philippejadin/storybox/hardware/tp4056.png

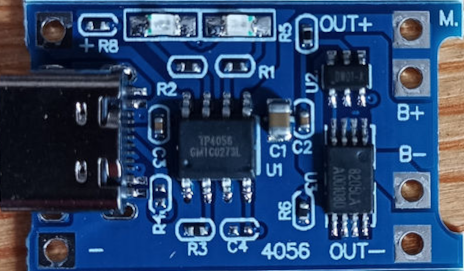
hardware/tp4056.png
