philippejadin/storybox/README.md

# Boite à histoire open source et open hardware, un projet du Fablab'ke

Consultez le repository officile du projet ici : https://github.com/fablabke/boite-histoire
