philippejadin/storybox/hardware/bom_mouser.xls

SHOPPING BASKET
This is not an invoice
05-Apr-24 07:38:11
 | Mouser No | Mfr. No | Manufacturer | Customer No | Description | RoHS | Lifecycle | Order Qty. | Price (EUR) | Ext.: (EUR)
1 | 179-CDS-5026-54E | CDS-5026-54E | CUI Devices |  | Speakers & Transducers 50 mm round, 26 mm deep, Foam + Paper, NdFeB, 5W, 4 ohm, 180Hz, solder eyelets | RoHS Compliant | New Product | 5 | 2,99 € | 14,95 €
2 | 485-4682 | 4682 | Adafruit |  | Memory IC Development Tools Adafruit Micro SD SPI or SDIO Card Breakout Board - 3V ONLY! | RoHS Compliant |  | 50 | 3,26 € | 163,00 €
3 | 485-3006 | 3006 | Adafruit |  | Amplifier IC Development Tools I2S 3W Class D Amp Breakout MAX98357A | RoHS Compliant |  | 15 | 5,53 € | 82,95 €
4 | 637-1N5817 | 1N5817 | Diotec Semiconductor |  | Schottky Diodes & Rectifiers Schottky, DO-15, 20V, 1A | RoHS Compliant By Exemption |  | 50 | 0,181 € | 9,05 €
5 | 179-PTN16-A10220K1B1 | PTN16-A10220K1B1 | CUI Devices |  | Potentiometers 17mm Pot, 10Kohm, Knurled shaft | RoHS Compliant | New Product | 30 | 1,15 € | 34,50 €
6 | 710-61302011821 | 61302011821 | Wurth Elektronik |  | Headers & Wire Housings WR-PHD 2.54mm Socket Header 20 pins | RoHS Compliant |  | 60 | 0,76 € | 45,60 €
7 | 710-61301611821 | 61301611821 | Wurth Elektronik |  | Headers & Wire Housings WR-PHD 2.54 mm Socke t Header; 16 pins | RoHS Compliant By Exemption |  | 30 | 0,567 € | 17,01 €
8 | 737-PH1-20-UA | PH1-20-UA | Adam Tech |  | Headers & Wire Housings 20P AU FLASH SINGLE ROW STRAIGHT | RoHS Compliant | New At Mouser | 60 | 0,193 € | 11,58 €
9 | 490-SJ1-3525NG-GR | SJ1-3525NG-GR | CUI Devices |  | Phone Connectors 3.5 mm, Stereo, Right Angle, Through Hole, Isolated Ground, 3 Conductors, 0 2 Internal Switches, Audio Jack Connector |  |  | 60 | 0,622 € | 37,32 €
10 | 358-SC0918 | SC0918 | Raspberry Pi |  | Single Board Computers Raspberry Pi Pico W | RoHS Compliant | New At Mouser | 20 | 5,58 € | 111,60 €
11 | 665-AS07108POR | AS07108PO-R | PUI Audio |  | Speakers & Transducers 8 OHM OVAL | RoHS Compliant |  | 10 | 3,11 € | 31,10 €
12 | 738-13154 | 13154 | AIM - American Iron and Metal |  | Solder Sn60/Pb40 OAJ 2% .032 DIA 1 lb. | No |  | 1 | 26,31 € | 26,31 €
13 | 179-CMS-2811-44E | CMS-2811-44E | CUI Devices |  | Speakers & Transducers 28 mm round, 11 mm deep, Foam, NdFeB, 3W, 4 ohm, 300Hz, solder eyelets | RoHS Compliant | New Product | 10 | 3,18 € | 31,80 €
14 | 602-3050-100-03 | 3050 RD005 | Alpha Wire |  | Hook-up Wire 24AWG 7/32 PVC 100ft SPOOL RED | RoHS Compliant |  | 1 | 29,63 € | 29,63 €
15 | 602-3050-100-02 | 3050 BK005 | Alpha Wire |  | Hook-up Wire 24AWG 7/32 PVC 100ft SPOOL BLACK | RoHS Compliant |  | 1 | 29,63 € | 29,63 €
16 | 602-3050/1-100-05 | 3050/1 YL005 | Alpha Wire |  | Hook-up Wire 24AWG SOLID PVC 100ft SPOOL YELLOW | RoHS Compliant |  | 1 | 24,47 € | 24,47 €
17 | 602-3050-100-06 | 3050 BL005 | Alpha Wire |  | Hook-up Wire 24AWG 7/32 PVC 100ft SPOOL BLUE | RoHS Compliant |  | 1 | 29,63 € | 29,63 €
18 | 179-TS14121280100SCR | TS14-1212-80-BK-100-SCR-D | CUI Devices |  | Tactile Switches 12 x 12 mm 8 mm 100 gf Short Crimped Black Through Hole SPST | RoHS Compliant | New Product | 120 | 0,173 € | 20,76 €
19 | 612-RA11131121 | RA11131121 | E-Switch |  | Rocker Switches 10A 125VAC 4.8mm Tab Off-On | RoHS Compliant |  | 30 | 0,525 € | 15,75 €
20 | 708-CF12JT100K | CF12JT100K | SEI Stackpole |  | Carbon Film Resistors - Through Hole 100KOhms 1/2W 5% Std Carbon | RoHS Compliant | New At Mouser | 100 | 0,02 € | 2,00 €
21 | 524-SDCS2/64GB | SDCS2/64GB | Kingston |  | Memory Cards 64GB Canvas Select Plus microSD |  | New Product | 20 | 6,38 € | 127,60 €
22 | 497-SP500202-1 | SP500202-1 | DB Unlimited |  | Speakers & Transducers Dynamic Speaker | RoHS Compliant |  | 10 | 2,21 € | 22,10 €
By submitting your order you agree to these terms and conditions. (https://www.mouser.be/saleterms) |  |  |  |  |  |  |  |  | Merchandise: | 918,34 €
Prices are reflected at the date and time shown. |  |  |  |  |  |  |  |  | Delivery Charge: | 0,00 €
