philippejadin/storybox/hardware/pico_label_plate/PicoLabelPlate.stl

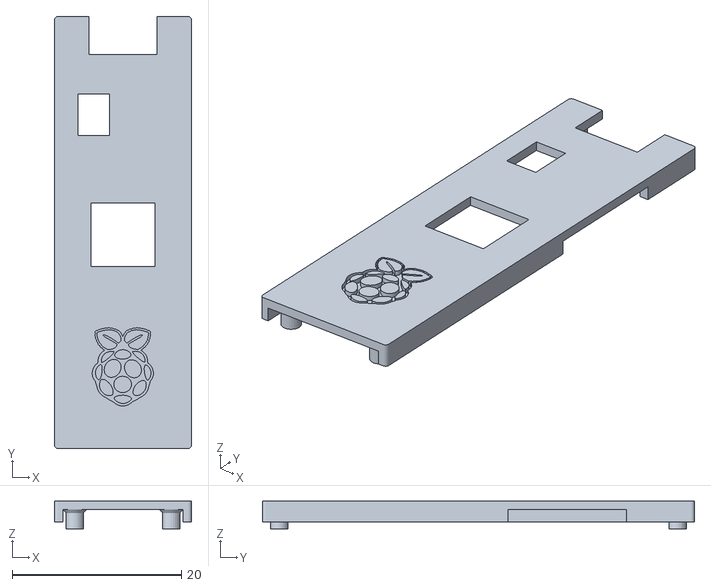
[picture p2: CAD file, 2024-04-19]
hardware/pico_label_plate/PicoLabelPlate.stl
16.2 x 51.0 x 3.30
