philippejadin/storybox/hardware/storybox/pdf/storybox.pdf

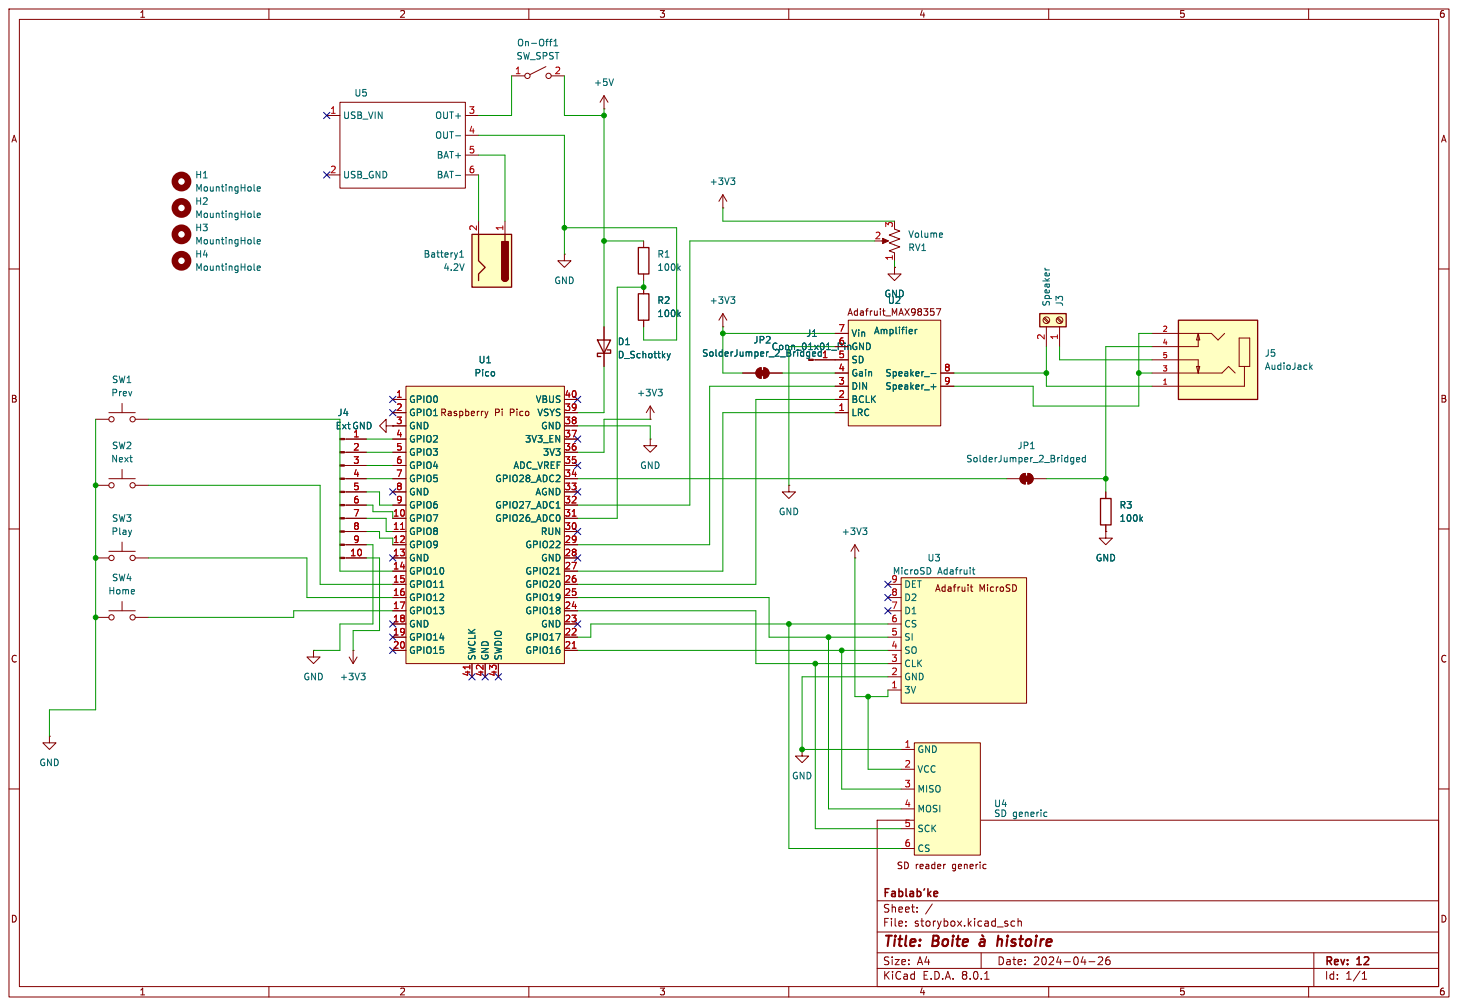
[picture p3: page 1]

File: storybox.kicad_sch Sheet: / Fablab'ke GND

Id: 1/1 Title: Boite þÿàhistoire
