philippejadin/storybox/hardware/pico_label_plate/PicoLabelPlateLabels 32ex.pdf

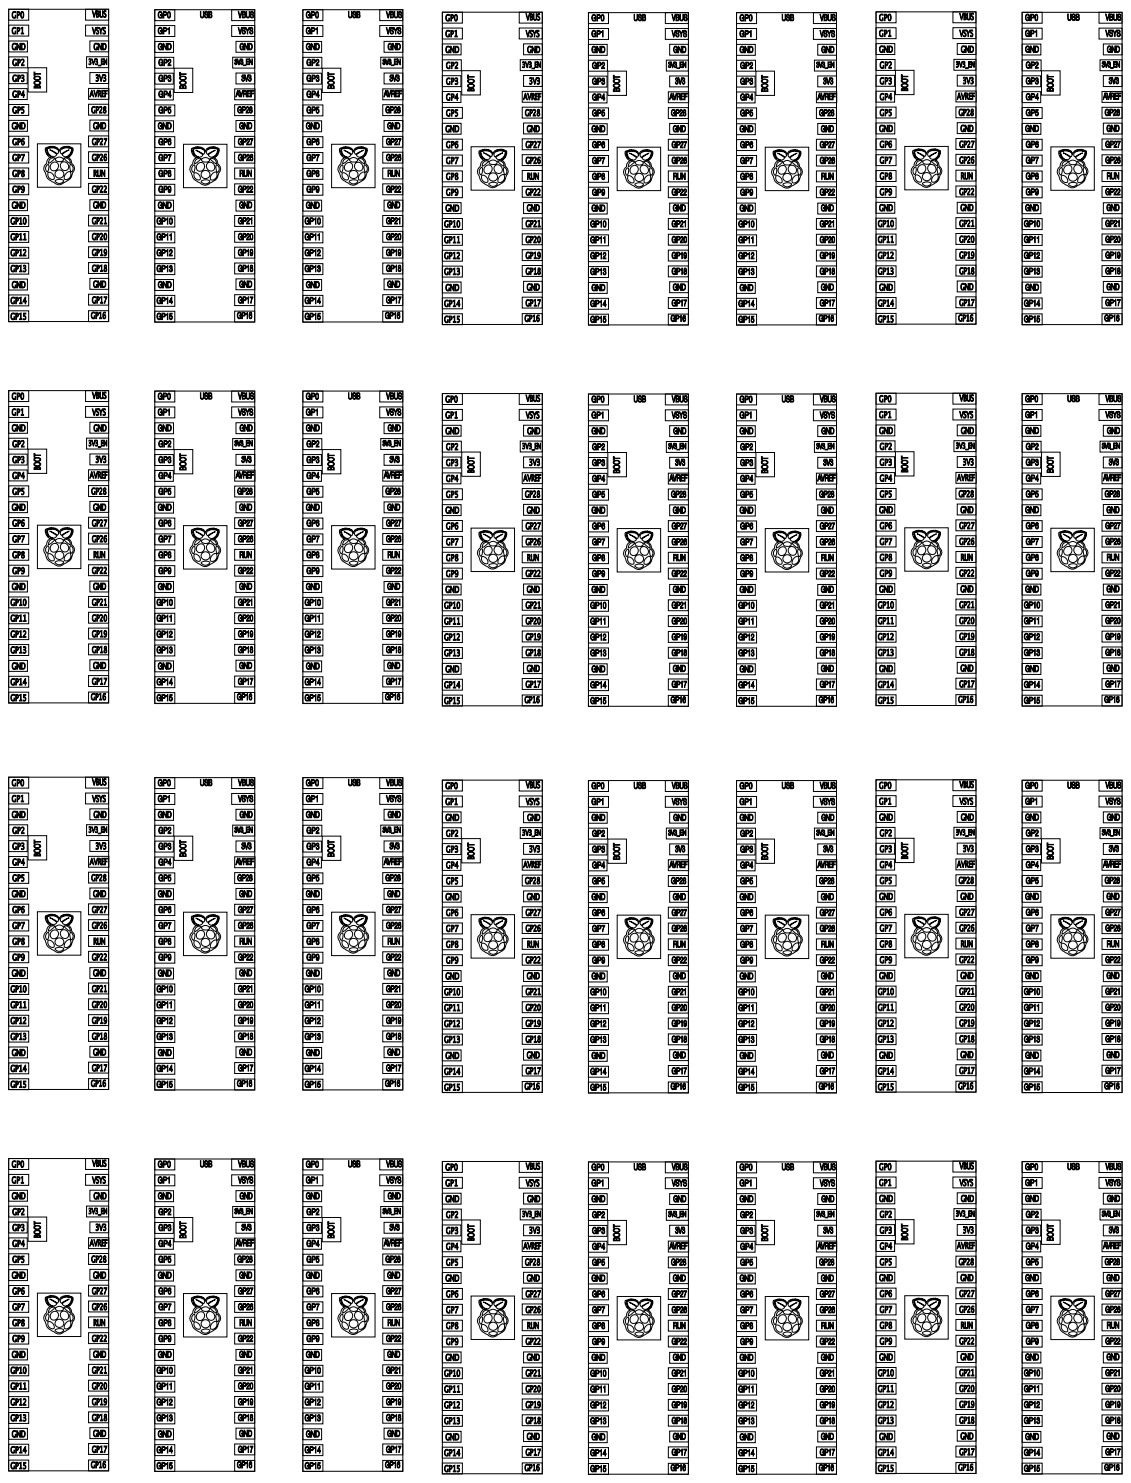
[picture p4: page 1]
