philippejadin/storybox/hardware/storybox/schematic.pdf

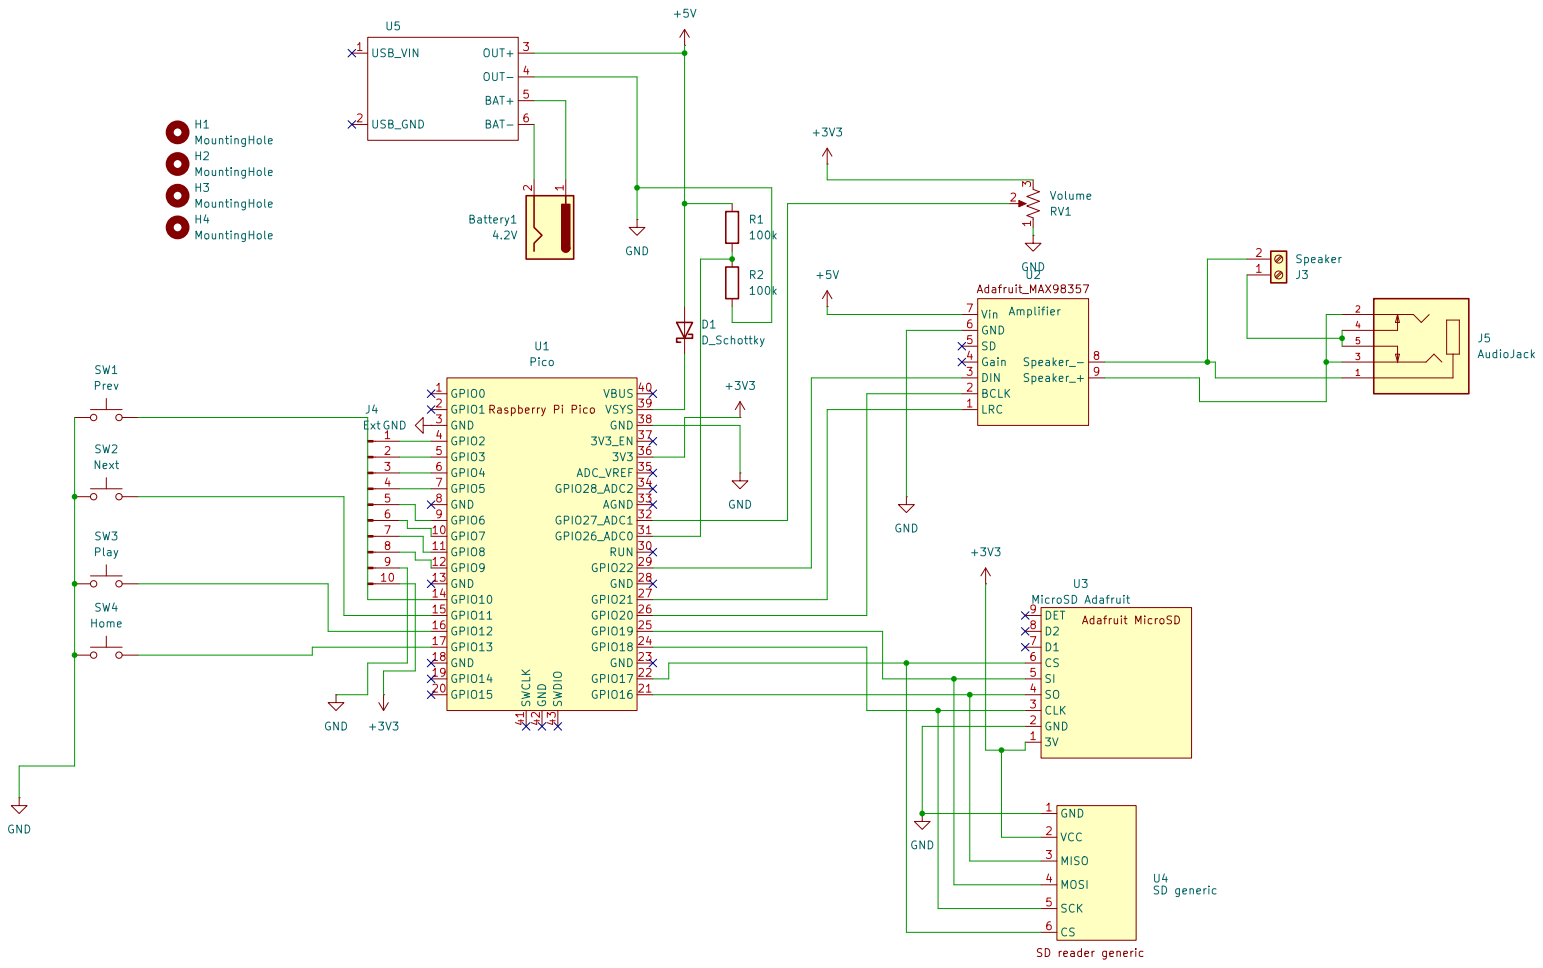
[picture p5: page 1]
