philippejadin/storybox/hardware/storybox/storybox.pdf

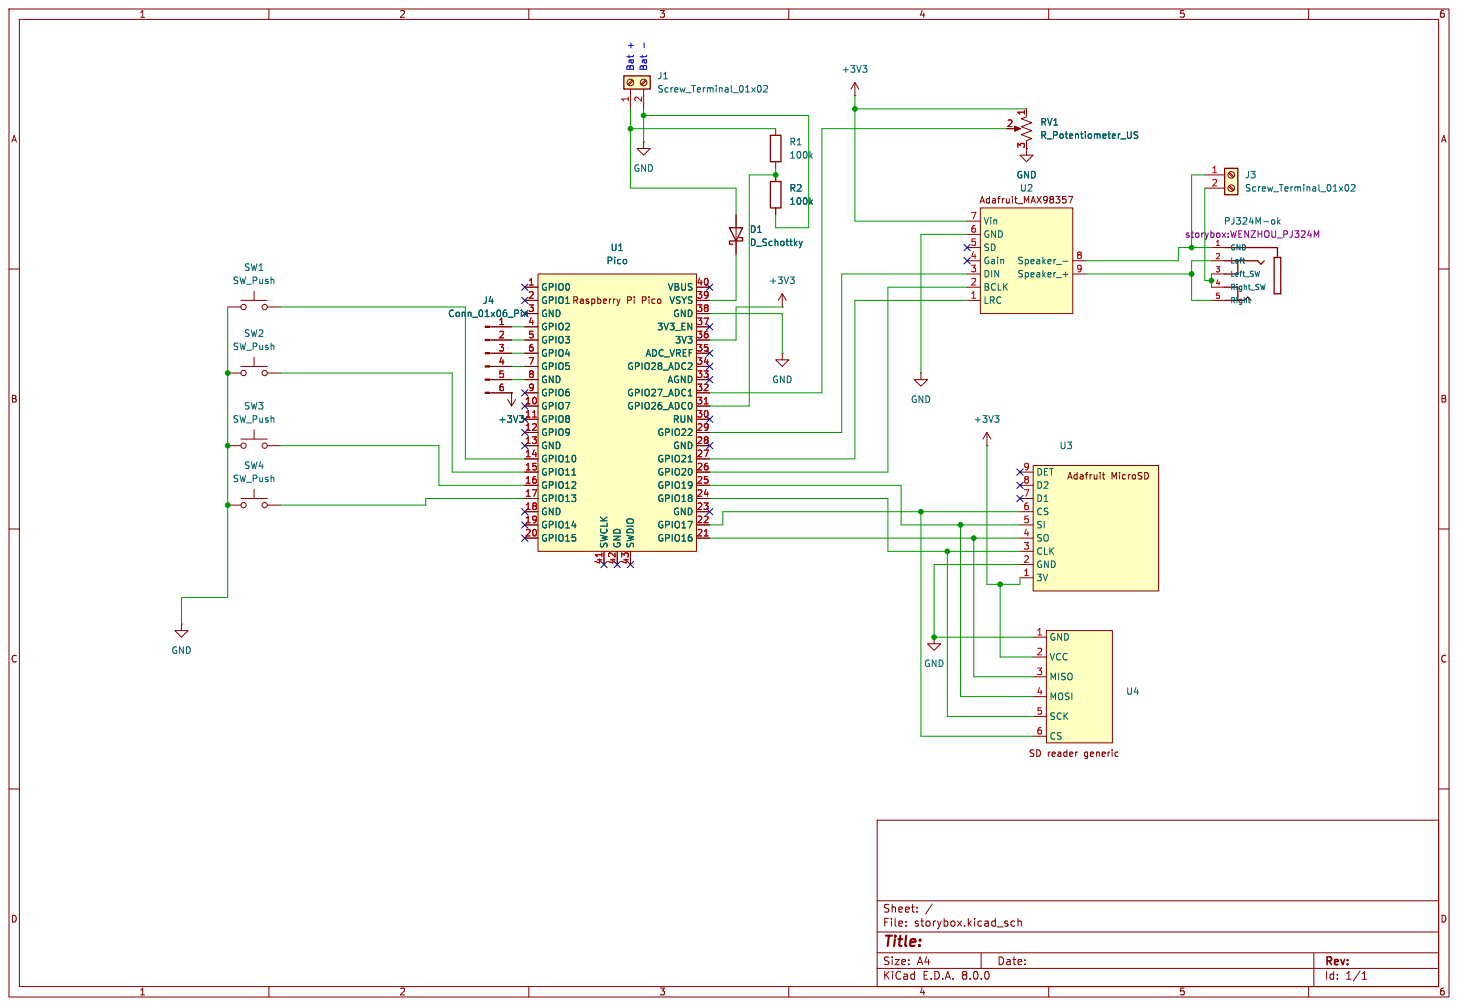
[picture p6: page 1]
