philippejadin/storybox/hardware/storybox/svg/output.pdf

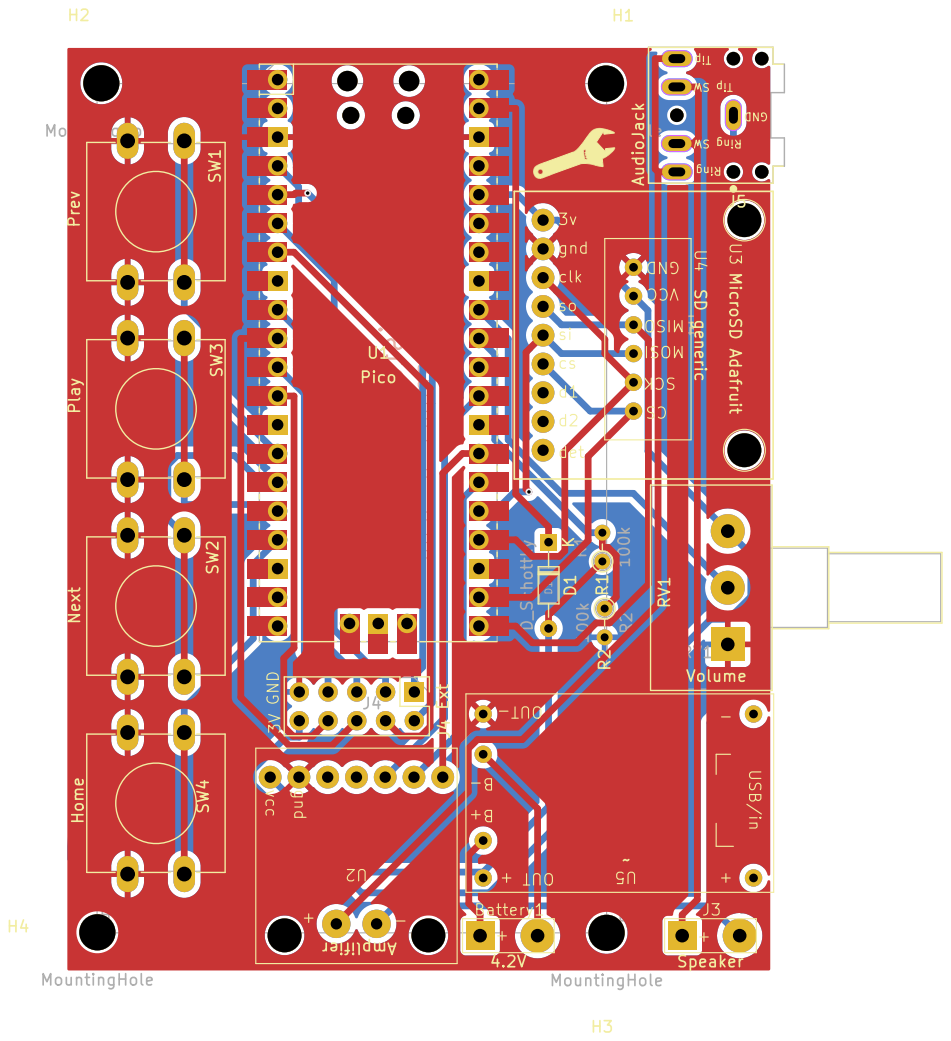
[picture p7: page 1]
