philippejadin/storybox/(list of files, drawings)

Other design files:
hardware/storybox/storybox.dsn
