philippejadin/storybox/hardware/storybox/storybox.kicad_pcb

## KiCad design hardware/storybox/storybox.kicad_pcb (2024-05-24)

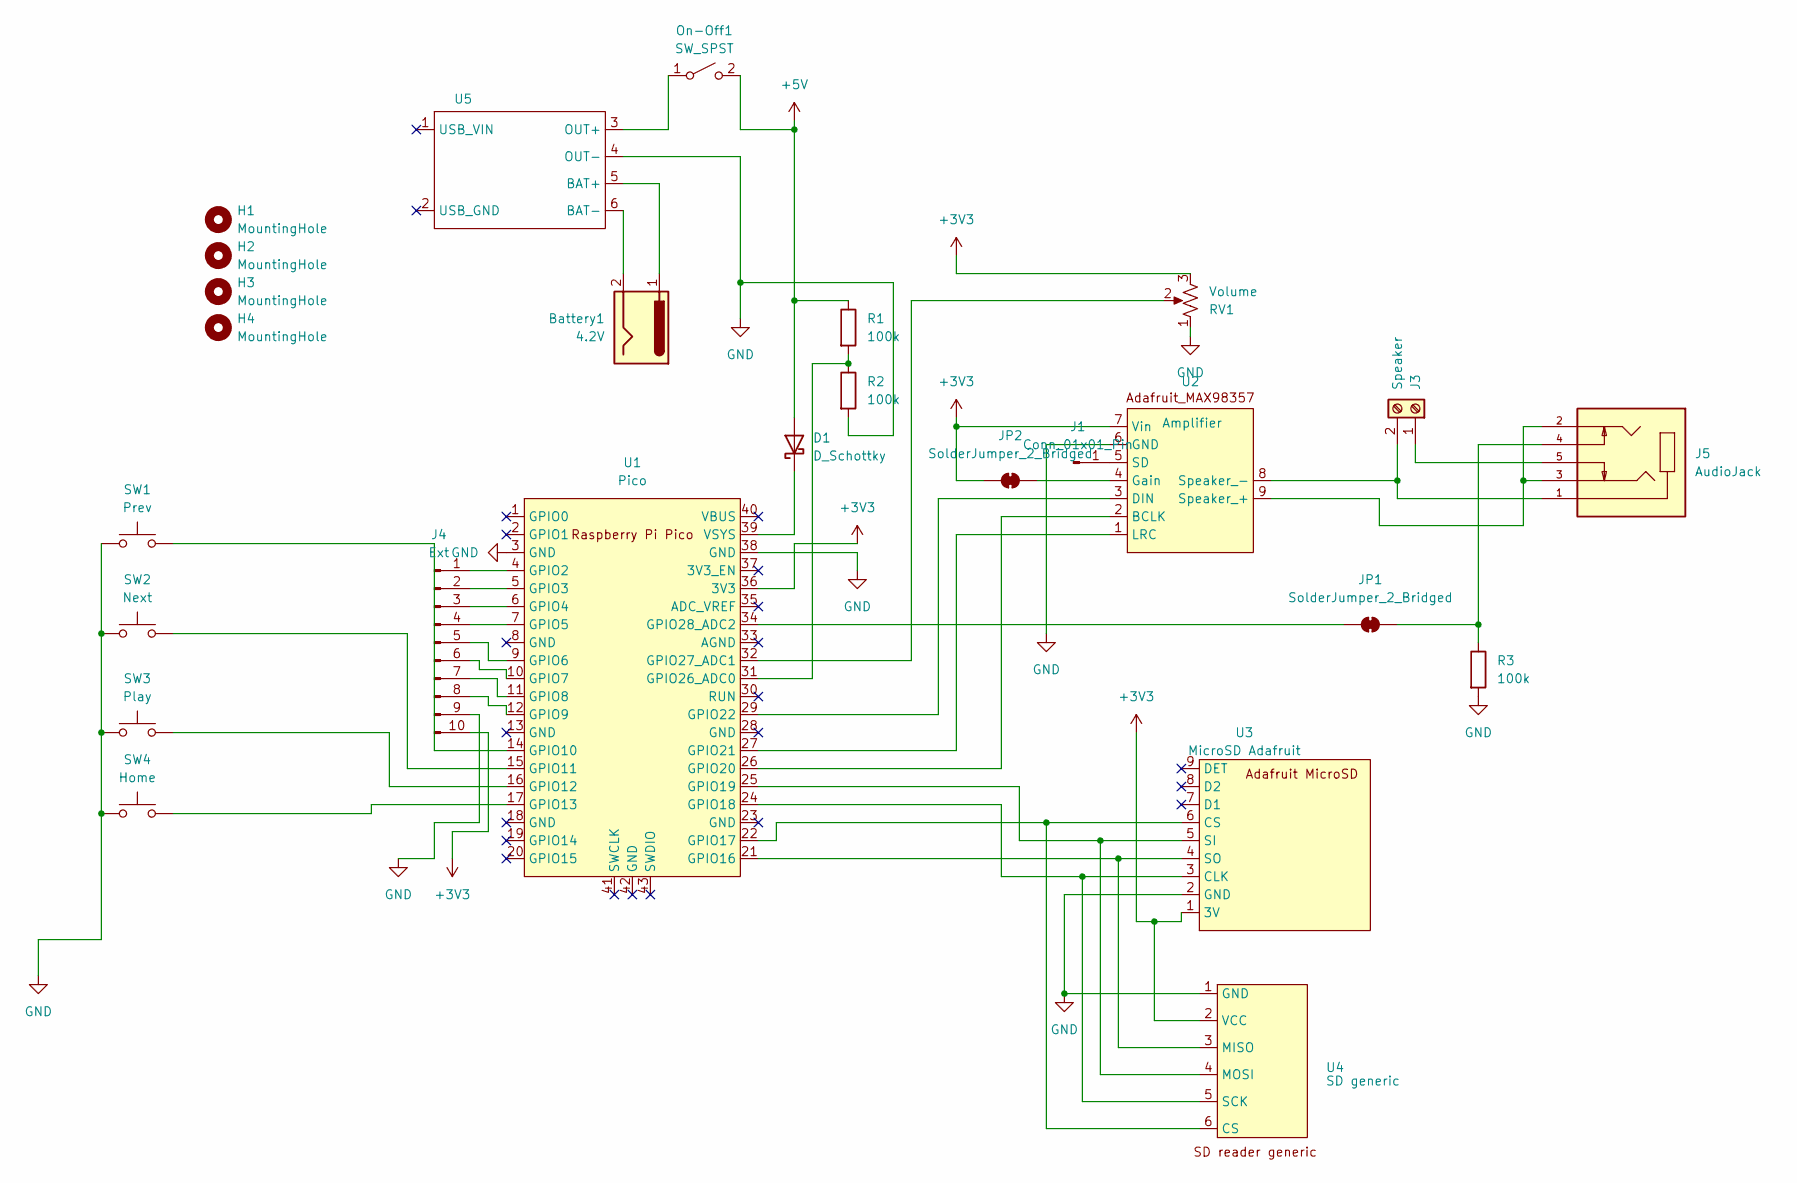
[picture p8: schematic storybox.kicad_sch, Boite à histoire]

Parts:
Battery1: 4.2V; connector_polarized
D1: D_Schottky; D_DO-15_P10.16mm_Horizontal
H1, H2, H3, H4: MountingHole; MountingHole_3.2mm_M3
J1: Conn_01x01_Pin; PinHeader_1x01_P2.54mm_Vertical
J3: Speaker; connector_polarized
J4: Ext; PinHeader_2x05_P2.54mm_Vertical
J5: AudioJack; CUI_SJ1-3525NG-GR
JP1, JP2: SolderJumper_2_Bridged; SolderJumper-2_P1.3mm_Bridged_Pad1.0x1.5mm
On-Off1: SW_SPST; connector_polarized
R1, R2, R3: 100k; R_Axial_DIN0204_L3.6mm_D1.6mm_P2.54mm_Vertical
RV1: Volume; Potentiometer_Alps_RK163_Single_Horizontal
SW1: Prev; SW_PUSH-12mm
SW2: Next; SW_PUSH-12mm
SW3: Play; SW_PUSH-12mm
SW4: Home; SW_PUSH-12mm
U1: Pico; RPi_Pico_SMD_TH
U2: Amplifier; Adafruit_MAX98357
U3: MicroSD Adafruit; Adafruit_MicroSd_3v
U4: SD generic; sd_reader_generic
U5: tp4056

Connections:
+3V3: J4.10, JP2.1 (A), RV1.3, U1.36 (3V3), U2.7 (Vin), U3.1 (3V), U4.2 (VCC)
+5V: D1.2 (A), On-Off1.2 (B), R1.1
GND: J4.9, R2.2, R3.2, RV1.1, SW1.2, SW2.2, SW3.2, SW4.2, U1.3 (GND), U1.38 (GND), U2.6 (GND), U3.2 (GND), U4.1 (GND), U5.4 (OUT-)
unnamed: D1.1 (K), U1.39 (VSYS)
unnamed: J1.1, U2.5 (SD)
unnamed: J3.1, J5.5
unnamed: J3.2, J5.1, U2.8 (Speaker_-)
unnamed: J4.1, U1.4 (GPIO2)
unnamed: J4.2, U1.5 (GPIO3)
unnamed: J4.3, U1.6 (GPIO4)
unnamed: J4.4, U1.7 (GPIO5)
unnamed: J4.5, U1.9 (GPIO6)
unnamed: J4.6, U1.10 (GPIO7)
unnamed: J4.7, U1.11 (GPIO8)
unnamed: J4.8, U1.12 (GPIO9)
unnamed: JP1.1 (A), U1.34 (GPIO28_ADC2)
unnamed: J5.4, JP1.2 (B), R3.1
unnamed: JP2.2 (B), U2.4 (Gain)
unnamed: On-Off1.1 (A), U5.3 (OUT+)
unnamed: SW1.1, U1.14 (GPIO10)
unnamed: SW2.1, U1.15 (GPIO11)
unnamed: SW3.1, U1.16 (GPIO12)
unnamed: SW4.1, U1.17 (GPIO13)
unnamed: U1.21 (GPIO16), U3.4 (SO), U4.3 (MISO)
unnamed: U1.22 (GPIO17), U3.6 (CS), U4.6 (CS)
unnamed: U1.24 (GPIO18), U3.3 (CLK), U4.5 (SCK)
unnamed: U1.25 (GPIO19), U3.5 (SI), U4.4 (MOSI)
unnamed: U1.26 (GPIO20), U2.2 (BCLK)
unnamed: U1.27 (GPIO21), U2.1 (LRC)
unnamed: U1.29 (GPIO22), U2.3 (DIN)
unnamed: R1.2, R2.1, U1.31 (GPIO26_ADC0)
unnamed: RV1.2, U1.32 (GPIO27_ADC1)
unnamed: J5.2, J5.3, U2.9 (Speaker_+)
unnamed: Battery1.1, U5.5 (BAT+)
unnamed: Battery1.2, U5.6 (BAT-)

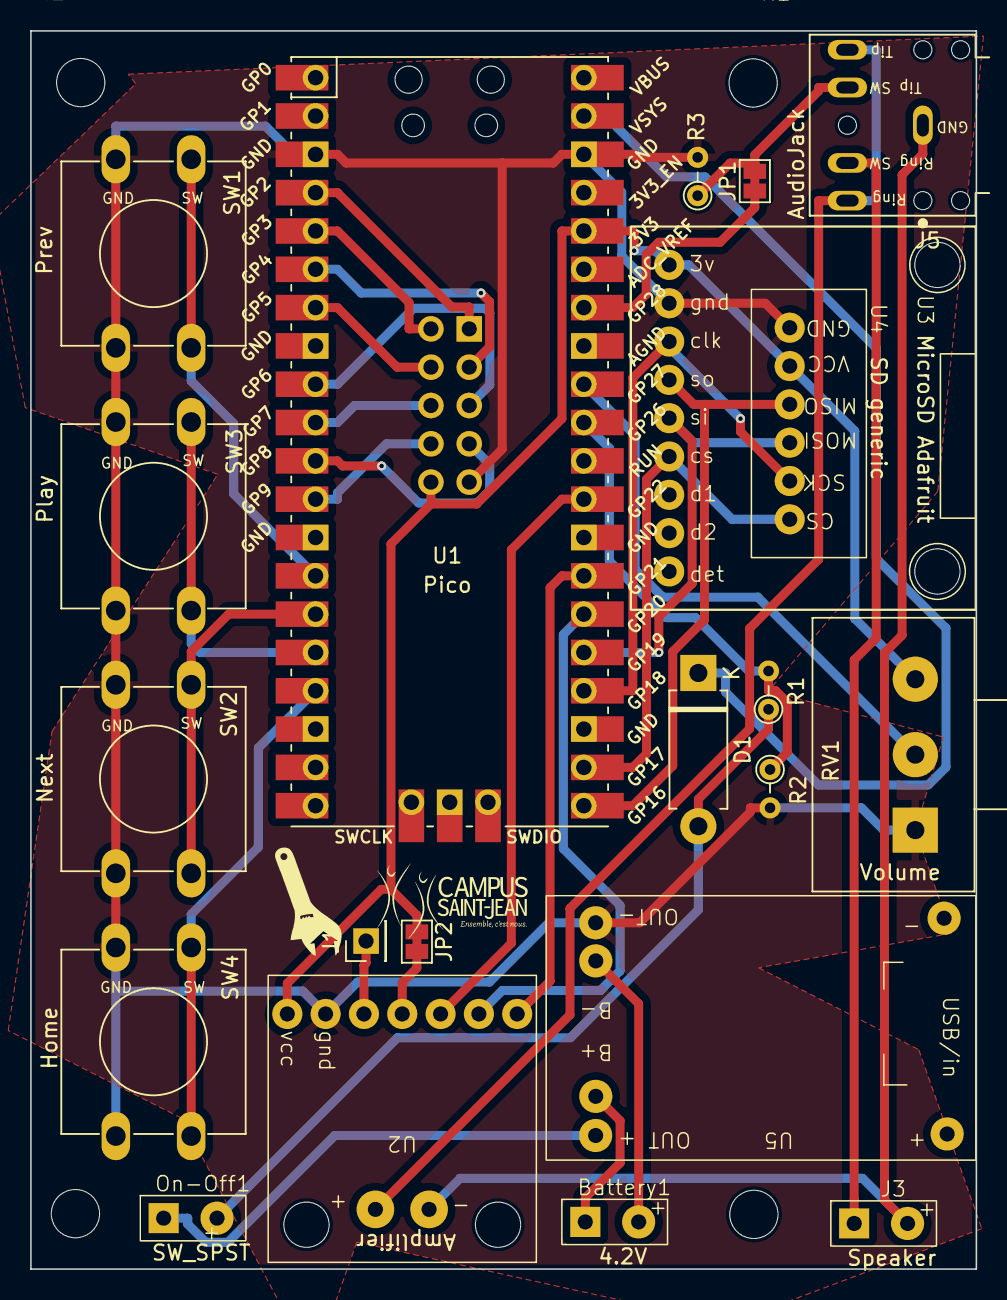
[picture p9: board storybox.kicad_pcb from above]

Board: 2 copper layers, 62.7 x 82.1 mm, 26 parts (1 on the bottom side), 35 nets.
