philippejadin/storybox/software/circuitpython/001/code.py

# SPDX-FileCopyrightText: 2021 Kattni Rembor for Adafruit Industries
#
# SPDX-License-Identifier: MIT

"""
CircuitPython single MP3 playback example for Raspberry Pi Pico.
Plays a single MP3 once.
"""
import board
import audiomp3
import audiopwmio
import time
import digitalio



audio = audiopwmio.PWMAudioOut(board.GP0)

decoder = audiomp3.MP3Decoder(open("01.mp3", "rb"))




button = digitalio.DigitalInOut(board.GP13)
button.switch_to_input(pull=digitalio.Pull.DOWN)

while True:
    if button.value:
        audio.play(decoder)
        #while audio.playing:
        #    pass
        time.sleep(0.1)
