philippejadin/storybox/software/circuitpython/014/tone.py

# SPDX-FileCopyrightText: 2018 Kattni Rembor for Adafruit Industries
#
# SPDX-License-Identifier: MIT

import time
import array
import math
import audiocore
import board
import audiobusio

print ("play tone")

sample_rate = 8000
tone_volume = .5  # Increase or decrease this to adjust the volume of the tone.
frequency = 440  # Set this to the Hz of the tone you want to generate.
length = sample_rate // frequency  # One freqency period
sine_wave = array.array("H", [0] * length)
for i in range(length):
    sine_wave[i] = int((math.sin(math.pi * 2 * frequency * i / sample_rate) *
                        tone_volume + 1) * (2 ** 15 - 1))

# For Feather M0 Express, ItsyBitsy M0 Express, Metro M0 Express
audio = audiobusio.I2SOut(board.GP20, board.GP21, board.GP22)

sine_wave_sample = audiocore.RawSample(sine_wave, sample_rate=sample_rate)

while True:
    audio.play(sine_wave_sample, loop=True)
    time.sleep(1)
    audio.stop()
    time.sleep(1)
