philippejadin/storybox/(commit log)

2024-04-26 inital commut v3
    [freerouting.dsn, storybox.dsn, storybox.kicad_pcb, storybox.kicad_sch, temp-freerouting.dsn]
2024-05-24 V3 pcb and latest code :-)
    [storybox.dsn, storybox.kicad_pcb, storybox.kicad_sch]
